Ins1ble/heart-rate-monitor/schemes/top_view_device_02.jpg

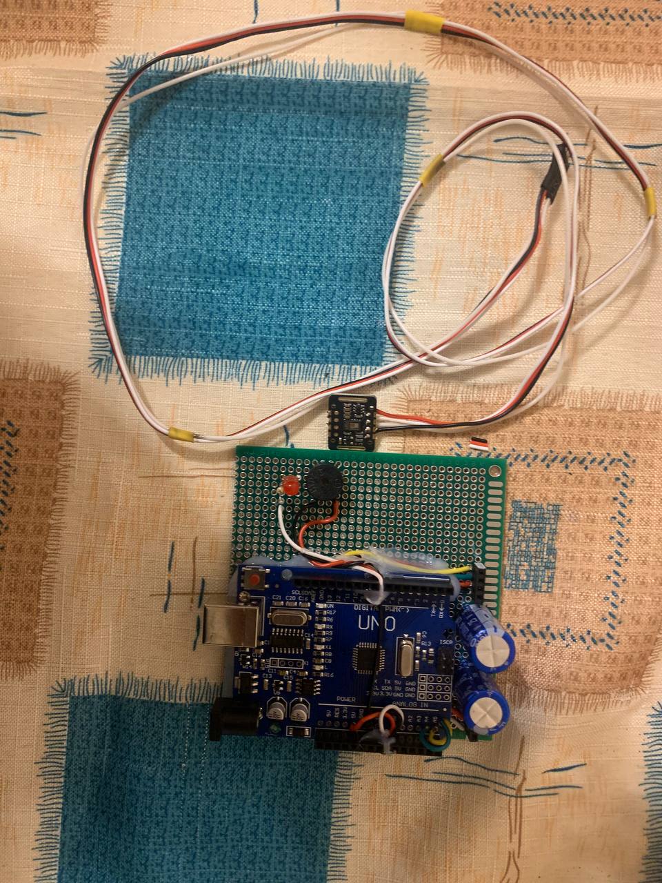
schemes/top_view_device_02.jpg
