Ins1ble/heart-rate-monitor/schemes/top_view_device.jpg

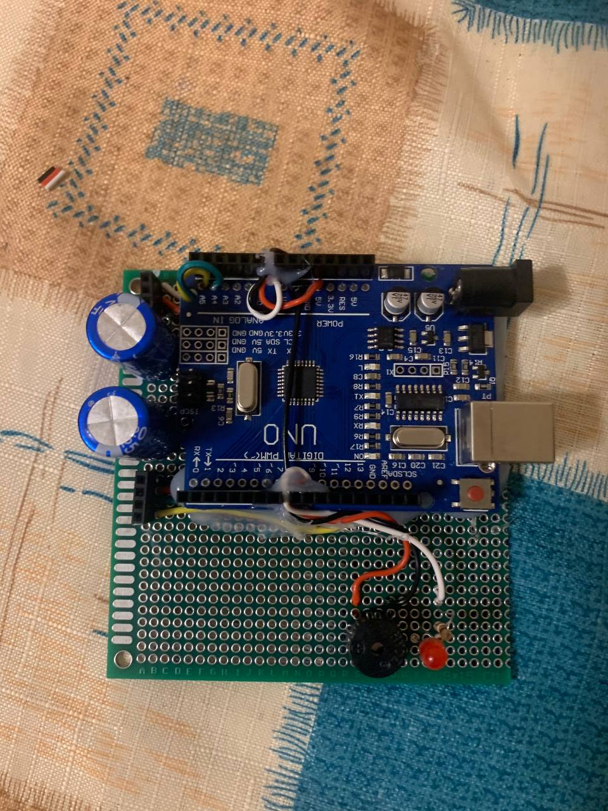
schemes/top_view_device.jpg
