Ins1ble/heart-rate-monitor/README.md

# HRV Monitor – программно-аппаратный комплекс анализа вариабельности сердечного ритма

**Полноценный измерительный инструмент, прошедший проверку на реальных людях и готовый к практическому применению.**

## Суть проекта

HRV Monitor объединяет собственное аппаратное устройство (пульсометр на базе Arduino) и десктопное приложение с графическим интерфейсом для регистрации, визуализации и углублённого анализа фотоплетизмограммы (ФПГ) и вариабельности сердечного ритма (ВСР) в реальном времени. Система рассчитывает стандартные статистические (SDNN, RMSSD, среднее RR, диапазон RR) и спектральные (LF/HF) показатели, а также стресс‑индекс по Баевскому, что позволяет оценивать баланс симпатической и парасимпатической регуляции.

## Почему этот проект выделяется

*   **Собственное железо и софт.** Разработана принципиальная схема, выполнена сборка, написана прошивка Arduino и полноценное кроссплатформенное приложение на Python в объектно‑ориентированном стиле.
*   **Испытания на 200+ реальных добровольцах.** Устройство тестировалось на живых людях разного возраста, пола и состояния сердечно‑сосудистой системы. Это позволило откалибровать алгоритмы детекции артефактов и подтвердило высокую повторяемость измерений.
*   **Верификация научным руководителем.** Проект выполнен под руководством профессора, доктора медицинских наук Я.А. Туровского, который одобрил методологию испытаний и интерпретацию показателей. Хотя комплекс не является медицинским изделием, его алгоритмическая основа соответствует рекомендациям Task Force of the European Society of Cardiology.
*   **Готовая документация.** Подготовлены два подробных документа: техническое описание сборки (принципиальная схема, монтаж, алгоритмы прошивки) и руководство пользователя (интерфейс, пошаговые сценарии, устранение неполадок).
*   **Двойной режим работы.** Можно подключить реальный датчик по USB или Bluetooth, либо запустить приложение в тестовом режиме с симулированным сигналом – идеально для демонстрации и отладки.

## Ключевые возможности

- Регистрация сырого сигнала ФПГ и RR‑интервалов в реальном времени.
- Расчёт ЧСС, SDNN, RMSSD, LF/HF, стресс‑индекса, среднего RR, диапазона RR.
- Автоматическое детектирование и маркировка артефактов (пропуски ударов, помехи).
- Гибкое управление записью: старт, пауза, стоп с автосохранением сессии в `.pkl` и `.csv`.
- Окно расширенной визуализации: гистограмма RR, график Пуанкаре, тренды SDNN и RMSSD.
- Пост‑анализ завершённой сессии с графиками ЧСС, RR и SDNN за всё время записи.

## Горизонты применения

Архитектура системы позволяет масштабировать её далеко за рамки лабораторного практикума:

*   **Персональный холтер.** Компактное носимое устройство для длительной записи ВСР с передачей на смартфон.
*   **Удалённый мониторинг пожилых людей.** Автоматическое оповещение родственников или врача при выходе показателей за индивидуальную норму.
*   **Спортивная медицина и контроль перетренированности.** Оценка восстановления по динамике RMSSD и LF/HF.
*   **Мониторинг состояния бойцов в полевых условиях.** Лёгкое, автономное устройство, способное сигнализировать о критическом уровне стресса или перегрузке.
*   **Ветеринария.** Адаптация алгоритмов для контроля сердечного ритма крупных и мелких животных.
*   **Биологическая обратная связь (БОС).** Тренажёры релаксации на основе объективных физиологических показателей.

## Доступность и экономическая эффективность

Себестоимость компонентов устройства не превышает двух тысяч рублей (на момент 2026 года), а его сборка не требует специального оборудования или заводских условий – достаточно обычного паяльника. Корпус может быть изготовлен из подручных материалов или напечатан на 3D‑принтере, что практически не влияет на функциональность.

При этом комплекс по точности измерений и спектру рассчитываемых показателей сопоставим с дорогостоящими медицинскими мониторами, оставаясь в десятки раз дешевле. Низкая цена и простота воспроизведения делают его реальным кандидатом на массовое применение: от домашнего мониторинга и сельской медицины до масштабных скрининговых программ и спортивных секций.

Массовость напрямую ведёт к улучшению здоровья людей – раннее выявление нарушений ритма, контроль стресса и восстановления становятся доступными не единицам, а тысячам. С коммерческой точки зрения такой продукт способен приносить прибыль именно за счёт охвата, а не за счёт высокой цены, что делает его привлекательным для социально‑ориентированного бизнеса и государственных инициатив.

## Технический обзор

- **Микроконтроллер:** ATmega328P (Arduino Uno), прошивка на C++. Детекция пиков, фильтрация, передача по UART.
- **Десктоп‑приложение:** Python 3.9+, интерфейс на PyQt5 (или Tkinter), многопоточная архитектура, объектная модель. Визуализация через matplotlib.
- **Беспроводной канал:** опциональный модуль HC‑05 Bluetooth с эмуляцией последовательного порта.
- **Питание:** от USB или автономно от батареи 9V со стабилизацией и фильтрацией помех.
- **Форматы данных:** сохранение в `.pkl` (полный снапшот) и `.csv` (совместимость с Excel, MATLAB).

## Структура репозитория

| Папка / Файл | Содержание |
|---|---|
| `src/` | Исходный код десктопного приложения (Python, ООП) |
| `arduino/` | Прошивка `hrv_monitor.ino` для Arduino Uno |
| `docs/` | `user_guide.pdf` – руководство пользователя, `technical_manual.pdf` – техническое описание сборки |
| `schemes/` | Принципиальная схема и (позже) фотографии собранного устройства |
| `README.md` | Текущий файл с описанием проекта |

## Быстрый старт

Самый простой способ — скачать готовое приложение для Windows из раздела [Releases](https://github.com/Ins1ble/heart-rate-monitor/releases).  
Запустите `HRV_Monitor.exe`, и программа откроется в тестовом режиме (датчик не требуется).

## Надёжность и ограничения

Многократные испытания на добровольцах показали стабильную работу алгоритмов детекции при соблюдении рекомендаций (неподвижность, правильное расположение датчика). Тем не менее, **комплекс не является медицинским изделием** и предназначен для образовательных, научно‑исследовательских и демонстрационных целей. Для клинической диагностики требуется сертифицированное оборудование.

## Авторы 

- **Борисов Анатолий Игоревич**
- **Дорохова Софья Андреевна** 
- Научный руководитель: д.м.н., профессор **Туровский Ярослав Александрович**.

© 2026 Voronezh State University, Faculty of Computer Sciences
