Ins1ble/heart-rate-monitor/schemes/bottom_view_device.jpg

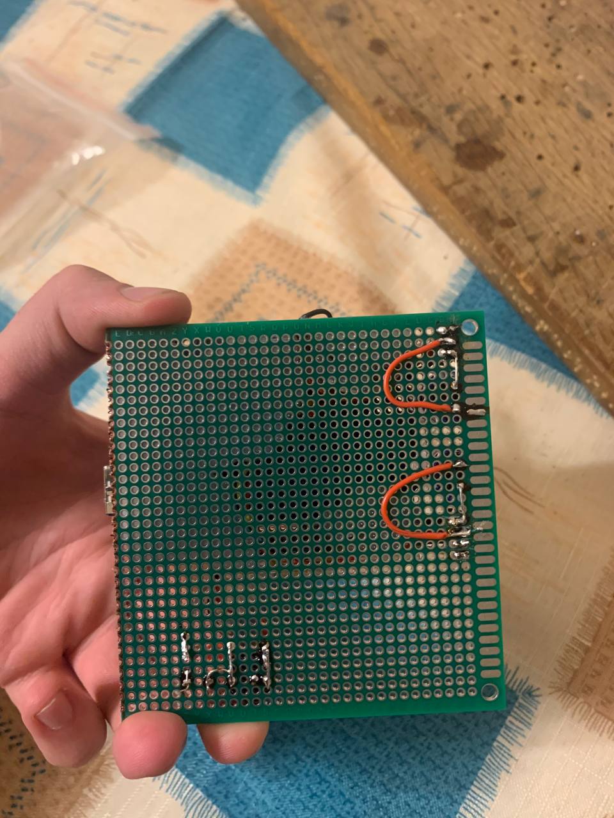
schemes/bottom_view_device.jpg
