Ins1ble/heart-rate-monitor/schemes/full_view_device_01.jpg

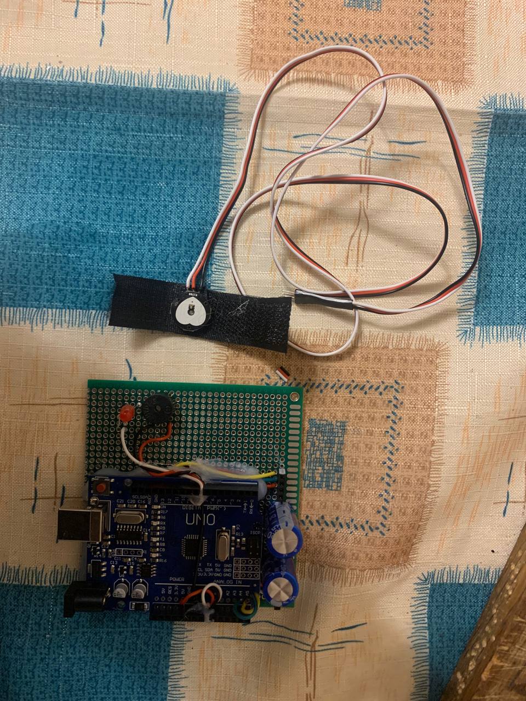
schemes/full_view_device_01.jpg
