Ins1ble/heart-rate-monitor/schemes/side_view_device_01.jpg

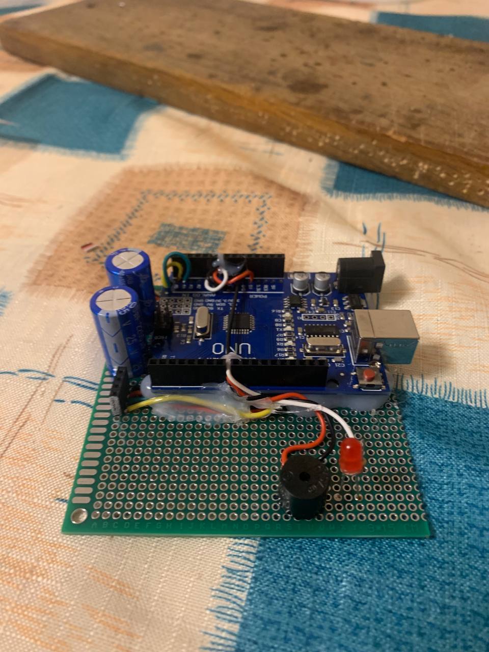
schemes/side_view_device_01.jpg
