Ins1ble/heart-rate-monitor/schemes/side_view_device_02.jpg

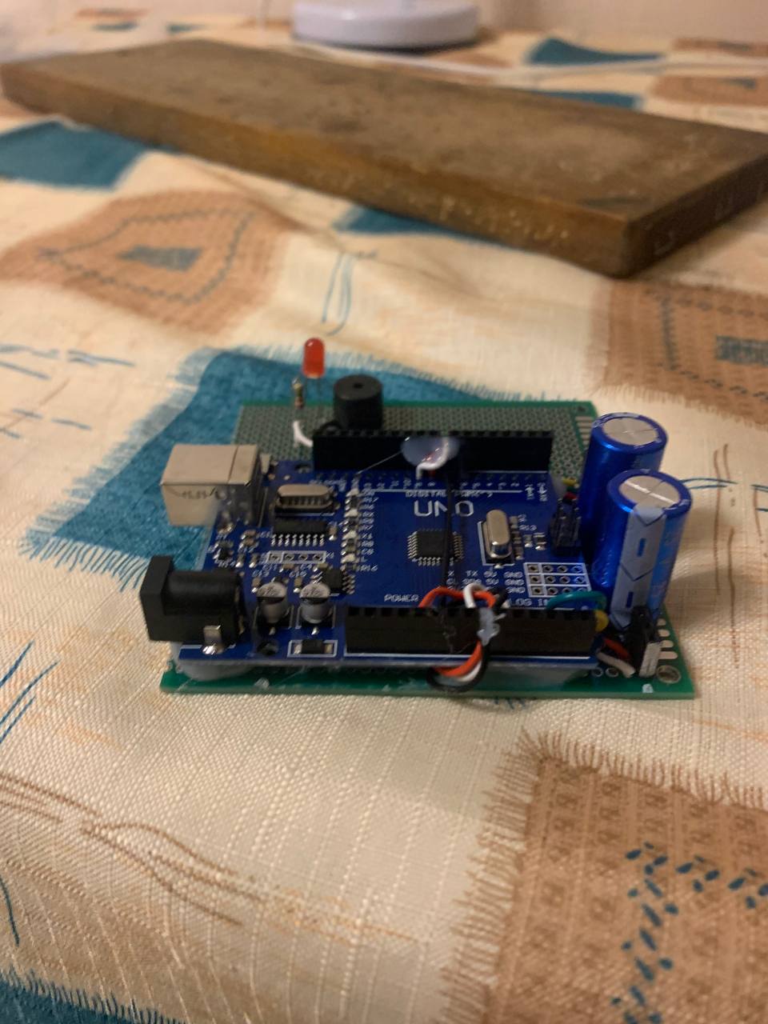
schemes/side_view_device_02.jpg
